benchmarex/BGA_Station_Atmel_1.1/README.md

# BGA_Station_Atmel_1.1
Program and schematic controller

PL

Program napisany przeze mnie w Atmel studio 6 w języku C na procesoprze XMEGA128-L

Stcja lutownicza do wymiany i lutowania układów BGA w płytach głównych. 

Projekt składa się z podgrzewacza dolnego o mocy 1600W (4 promienniki podczerwieni każdy po 400W) który podgrzewa naprawianą płytę. Zapewnia początkowe grzanie płyty, i poźniej grzanie po profilu lutowniczym. W odpowiednim momencie lutowania jest dołączana górna grzałka. Lutowanie i przebieg temperatury odbywa się według zaprogramowanego profilu grzewczego dla grzałki podgrzewacza dolnego i górnego. Jako grzałka górna wykorzystywana jest lampa halogonewa 100W 12V platerowana złotem. Halogeny z napylonym aluminium tzw. srebrne nie nadają się do lutowania gdyż wiekszość ciepła jest emitowana na samym halogenie a nie przekazana strumieniem podczerwieni na lutowany układ jak to ma w przypadku halogena platerowanego złotem. Nie jest stosowana żadna dodatkowa optyka wystarczy halegone zaiwsić 10-15cm nad lutowanym układem. Kontrola temperatury odbywa się za pomocą termopar 'thermocouple' są to 2 termopary typu K produkcji Omega o średnicy kulki 80um (80e-6m). Jedna termopara jest przyklajana w pobliże lutowanego układu bga około 1cm po tej samej stronie co układ BGA za pomocą taśmy kaptonowej. Druga termopara jest bezpośrednio przyklejona na lutowanym układzie BGA. Program jest automatyczny tzn wystrczy uruchomić lutowanie i cały proces lutowanie przebiegnie automatycznie, poza poózeniem i zdjeciem układu :).  Podczas wykonia programu lutowania istnieje możliwość wstrzymania, cofnięcia lub przyspieszenia programu. Czasem jest to potrzebne ze względu na czynniki losowe np. odklejenie sie termopary, duży układ, mały układ. Dodatkowo jest wbudowany mechanizm zabezpieczający przed nadmierną róznicą temperatur pomiedzy płytą i lutowanym układem. Brak takiego zabezpieczenia grozi zniszczeniem układu lub płyty (wygięcia, rozwarstwienia PCB). 
Komunikaty wyświtlane są na wyswietlaczu LCD, sterowanie odbywa się przciskami. Profil lutowniczy dla dolnej i górnej grzałki został opracowany przezmnie na podstawie własnych obserwacji i doświadczeń w lutowaniu układów BGA. Można dokonać przełączenia w typu spoiwa ołowiowe lub bezołowiowe. Dla bezołowiowego temperatura jest przeliczana o wymaganą róznicę. Czasy ekspozycji nie są zmieniane. 

EN

Program written by me in Atmel studio 6 in C language on XMEGA128-L processor

Soldering station for replacing and soldering the BGA system in motherboards.

The design consists of a bottom heater with a power of 1600W (4 radiators of 400W each), which heats the repaired board. Provide pre-heating of the board, and subsequent heating after the soldering profile. At some point in the soldering process, the top heater is attached. Soldering and temperature course is done in accordance with the heating level standard for the lower and upper heater heater. As the top heater, a 100W 12V gold-plated halogen lamp is used. Halogens with sputtered aluminum, the so-called The reverse is not visible for soldering so that most of the heat is emitted on the halogen itself and not transferred to the soldered system as in the case of gold-plated halogen. There is no standard of optics, it is enough to hang 10-15 cm above the soldered system. Temperature control is carried out using thermocouples "thermocouple" are 2 type K thermocouples manufactured by Omega with a diameter of 80um (80e-6m). One thermocouple is glued near the soldered BGA chip about 1cm on the same side as the BGA chip with Kapton. The second thermocouple is directly glued on the soldered BGA chip. The program is automatic, i.e. it is enough to call soldering and the whole soldering process will run real, apart from positioning and removing the system :). While the soldering program is running, it is possible to run, undo or accelerate the program. Sometimes it is needed due to random formation, e.g. thermocouple detachment, large system, small system. In addition, it is a mechanism against excessive temperature difference between the board and the soldered system. Lack of such protection may damage the system or the board (bends, PCB delamination).
Messages are displayed on the LCD display, operation is carried out with buttons. The soldering profile for the function and function of the heater was used by me based on observations and experiences in BGA soldering. It was possible to connect a switch to the type of lead or lead-free binder. For lead free the temperature is recalculated by the required difference. Impact times are not changed.
