benchmarex/BGA_Station_Atmel_1.1/BGA_soldering_station.PDF

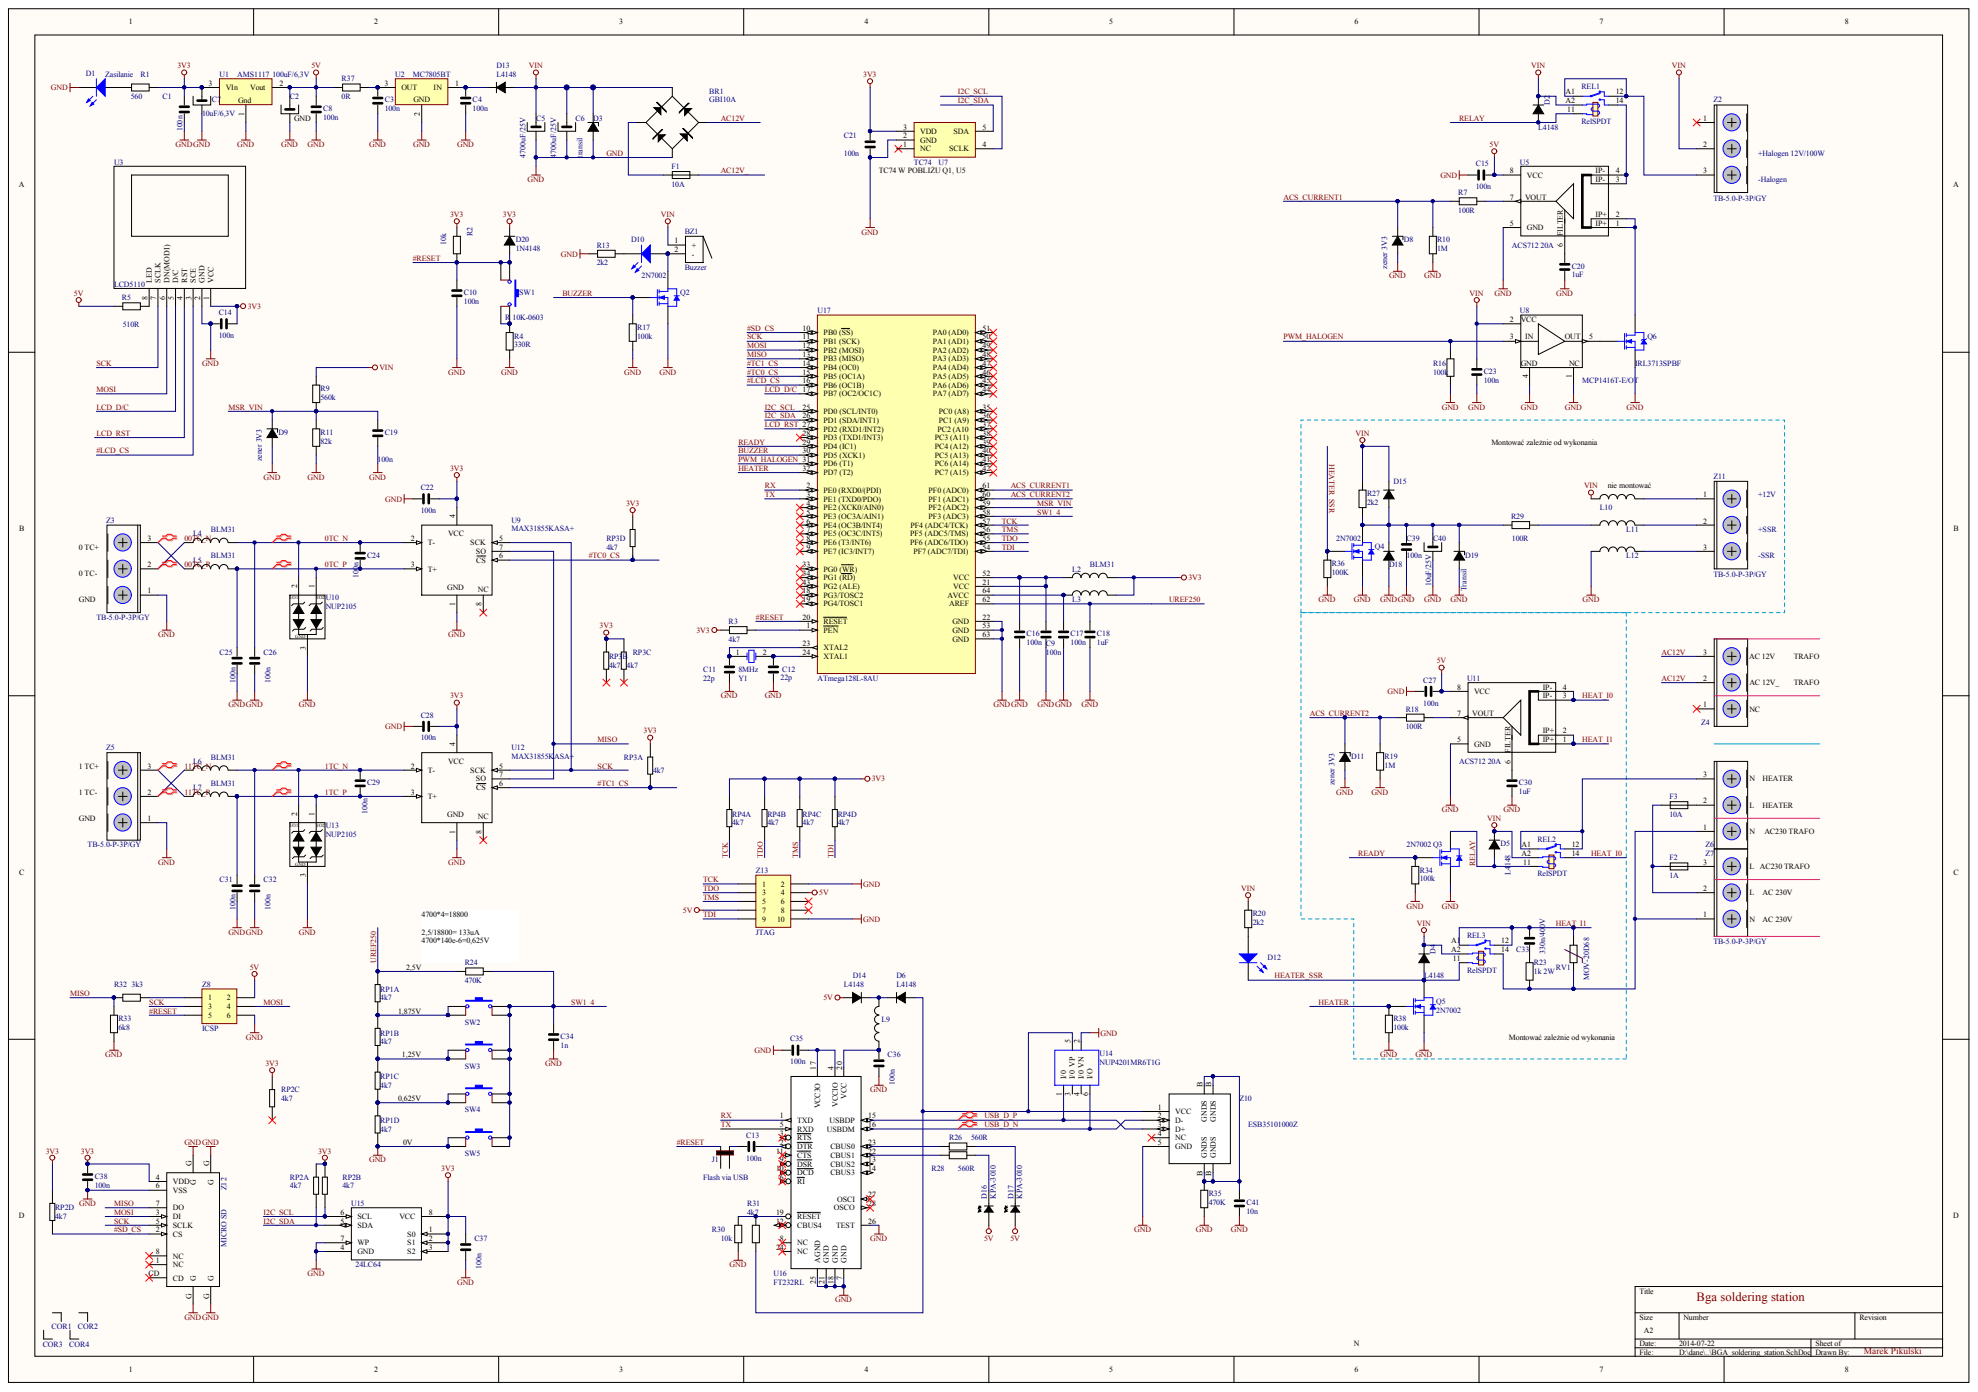
[picture p1: page 1]

VCC 1 GND 2 SCE 3 RST 4 D/C 5 DN(MODI) 6 SCLK 7 LED 8

Montować zależnie od wykonania

A1 | 12 REL2 | Z6 Z7 3

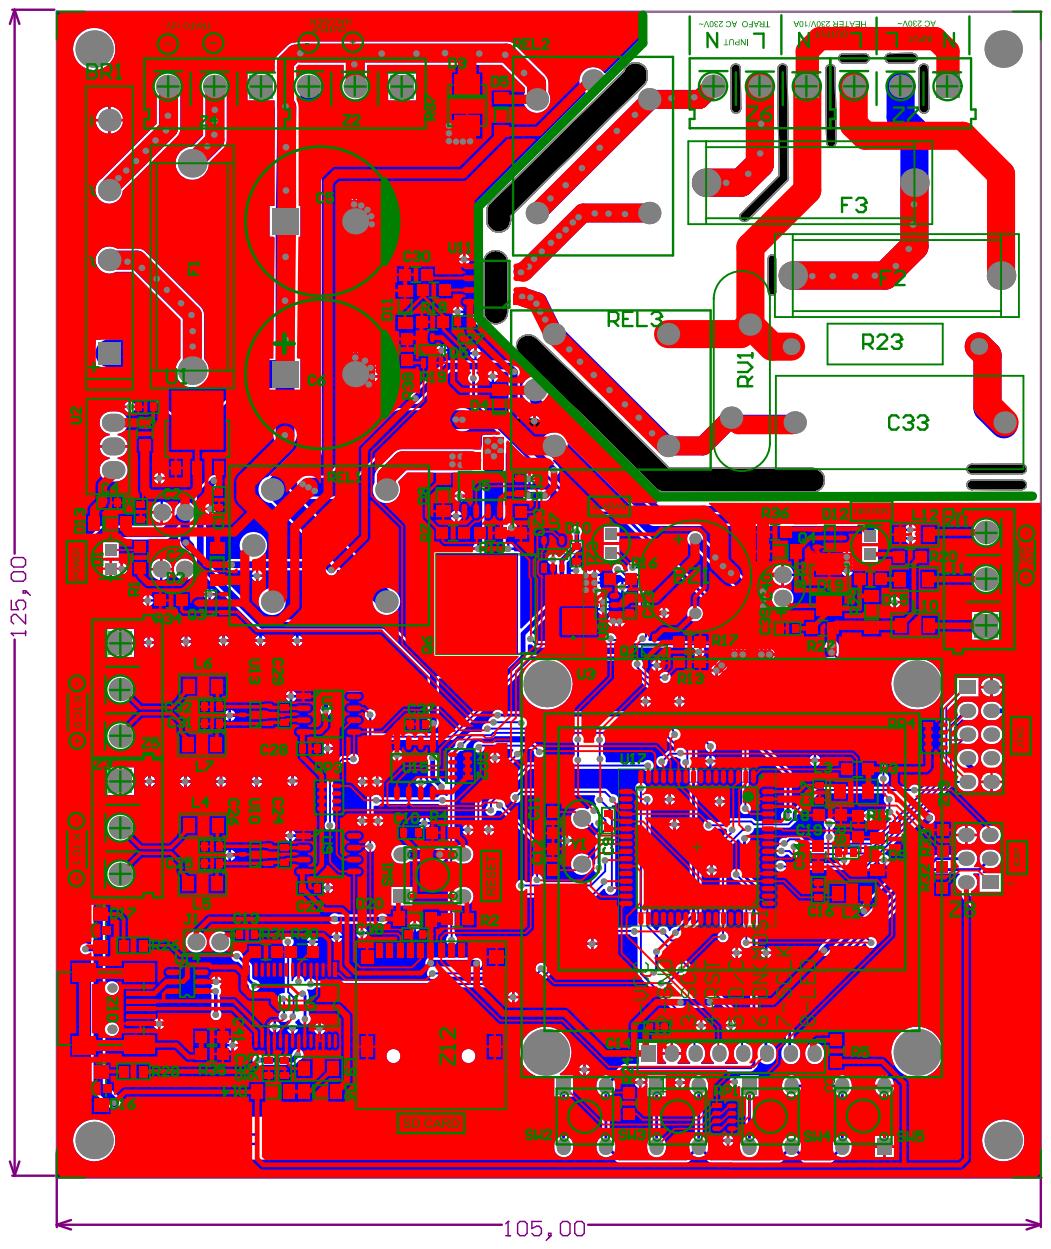
[picture p2: page 2]

Comment | Description | Designator | Footprint | LibRef | Quantity
GBI10A | DIOTEC SEMICONDUCTOR GBI10A - Mostek prostowniczy; płaski; 50V; 10A | BR1 | Mostek prostowniczy | GL1.5A | | 1
Buzzer | | BZ1 | Buzzer | Buzzer | | 1
100n | Kondensator | C1, C3, C4, C8, C9, C10, C13, C14, C15, C16, C17, C19, C21, C22, C23, C24, C25, C26, C27, C28, C29, C31, C32, C35, C36, C37, C38, C39 | 0603-C | C | 28
100uF/6,3V | | C2 | C stojący mały | Electrolitic Capacitor | | 1
4700uF/25V | | C5, C6 | C DUZY STAJACY THT | Electrolitic Capacitor | | 2
10uF/6,3V | | C7 | C stojący mały | Electrolitic Capacitor | | 1
22p | Kondensator | C11, C12 | C 805 | C | | 2
1uF | Kondensator | C18, C20, C30 | C 805 | C | | 3
330n/400V | Kondensator | C33 | C WXE-334K | C | | 1
1n | Kondensator | C34 | C 805 | C | | 1
10uF/25V | | C40 | C stojący mały | Electrolitic Capacitor | | 1
10n | Kondensator | C41 | C 805 | C | | 1
FLX_corner | Zakres obwodu drukowanego używany przez FLX2010 | COR1, COR2, COR3, COR4 | COR_1 | FLX_corner | | 4
Zasilanie | Typical BLUE SiC LED | D1 | led3 | LED3 | | 1
L4148 | Diode | D2, D4, D5, D6, D13, D14 | MINIMELF | DIODE | | 6
transil | Diode, Trransil 12V 1SMB59XXBT3 | D3, D19 | SOD90A | 1SMB59XXBT3 | | 2
zener 3V3 | | D8, D9, D11 | MINIMELF | 1SMB59XXBT3 | | 3
| Typical BLUE SiC LED | D10, D12 | led3 | LED3 | | 2
DIODE | Diode | D15, D18 | MINIMELF | DIODE | | 2
KPA-3010 | LED | D16, D17 | KPA-3010 | LED | | 2
1N4148 | Diode | D20 | MINIMELF | DIODE | | 1
10A | Bezpiecznik | F1, F3 | FUSE | FUSE | | 2
1A | Bezpiecznik | F2 | FUSE | FUSE | | 1
Flash via USB | | J1 | JP2.5 | JMP2 | | 1
BLM31 | Cewka | L2, L3, L4, L5, L6, L7, L9, L10, L11, L12 | 1206 | L | 10
2N7002 | N-channel Enhancement Mode Field-effect Transistor | Q2, Q3, Q4, Q5 | SOT23 | 2N7002 | | 4
IRL3713SPBF | HEXFET N-Channel Power MOSFET | Q6 | D2PAK | IRFBF20 | | 1
560 | Rezystor | R1 | R 805 | R | | 1
10k | Rezystor | R2, R30 | R 805 | R | | 2
4k7 | Rezystor | R3, R31 | R 805 | R | | 2
330R | Rezystor | R4 | R 805 | R | | 1
510R | Rezystor | R5 | R 805 | R | | 1
100R | Rezystor | R7, R18, R29 | R 805 | R | | 3
560k | Rezystor | R9 | R 805 | R | | 1
1M | Rezystor | R10, R19 | R 805 | R | | 2
82k | Rezystor | R11 | R 805 | R | | 1
2k2 | Rezystor | R13, R20, R27 | R 805 | R | | 3
100k | Rezystor | R16, R17, R34, R36, R38 | R 805 | R | | 5
1k 2W | Rezystor | R23 | R20/4 | R | | 1
470K | Rezystor | R24, R35 | R 805 | R | | 2
560R | Rezystor | R26, R28 | 0805 | R | | 2
3k3 | Rezystor | R32 | R 805 | R | | 1
6k8 | Rezystor | R33 | R 805 | R | | 1
0R | Rezystor | R37 | R 805 | R | | 1
RelSPDT | RELPOL RM51-3011-85-1012 - Przekaźnik: elektromagnetyczny; SPDT; Ucewki :12VDC; 10A/250VAC | REL1, REL2, REL3 | relay rm51 | RelSPDT | | 3
4k7 | drabinka 1204 4x0603 | RP1, RP2, RP3, RP4 | drabinka 4d03 | RP_MINI4 | | 4
MOV-20D68 | varistor | RV1 | MOV-20D681K | V250 | | 1
SW 6X6X4.3 | MIKROSWITCH 6X6X4.3MM THT | SW1, SW2, SW3, SW4, SW5 | MICROSWITCH 6X6X4.3 | SW 6X6X4.3 | | 5
AMS1117 | AMS1117 | U1 | sot223 | AMS1117 | | 1
MC7805BT | 3-Terminal Positive Fixed Voltage Regulator | U2 | to220.1 | MC7805BT | | 1
LCD5110 | SPI LCD NOKIA 5110 MODULE | U3 | LCD5110 | LCD5110 | | 1
ACS712 20A | ADS712 BIDIRECTIONAL CURRENT SENSOR | U5, U11 | SO8 | ACS712 | | 2
TC74 | MICROCHIP DIGITAL I2C 8BIT TEMP. | U7 | SOT23-5 | TC74 | | 1
MCP1416T-E/OT | Tiny 1.5A, High-Speed Power MOSFET Driver | U8 | SOT23-5 | MCP1416T | | 1
MAX31855KASA+ | Cold-Junction Compensated Thermocouple-to-Digital Converter | U9, U12 | SO8 | MAX31855 | | 2
NUP2105 | DUAL LINE TVS DIODE | U10, U13 | SOT23 | NUP2105 | | 2
NUP4201MR6T1G | | U14 | TSOP6 | NUP4201 | | 1
24LC64 | EEPROM | U15 | SO8 | 24LC04 | | 1
FT232RL | Single USB 2.0 to Serial UART Converter IC. | U16 | SSOP28-MAX | FT232RL | | 1
ATmega128L-8AU | 8-bit AVR Microcontroller, 4.5-5.5V, 128KB Flash, 4KB EEPROM, 4KB SRAM, 64-pin TQFP, Industrial Grade (-40°C to 85°C), Pb-Free | U17 | _64A_L | ATmega128-16AU | | 1
8MHz | Crystal Oscillator | Y1 | xtal.1 | XTAL | | 1
TB-5.0-P-3P/GY | lISTWA ZACISKOWA KĄTOWA 90ST TB-5.0-P-3P/GY NININGI | Z2, Z3, Z4, Z5, Z6, Z7, Z11 | LISTWA ZACISKOWA KĄTOWA 90ST TB-5.0-P-3P/GY NININGI | TB-5.0-P-3P | | 7
ICSP | Header, 3-Pin, Dual row | Z8 | Header 2x3 | Header 3X2 | | 1
ESB35101000Z | Gniazdo MINI USB-C kątowe SMD 5pin | Z10 | mini-usb ESB35101000Z | Mini_USB_C | | 1
MICRO SD | MICRO SD HOLDER | Z12 | MICROSD | MICRO SD | | 1
JTAG | Header, 5-Pin, Dual row | Z13 | Header 2x5 | Header 5X2 | | 1
