benchmarex/BGA_Station_Atmel_1.1/BGA_station/R_temp31855.h

/*
 * R_temp31855.h
 *
 * Created: 2015-01-21 20:25:53
 *  Author: Marek
 */ 

#ifndef R_temp31855_H_
#define R_temp31855_H_

#define FALSE                      0
#define TRUE                       1
//zwracana temperatura w st C w argumencie podaæ wyprowadzenie portu pod ktory podpiety jestr CS ukladu

int16_t  R_temp31855 ( uint8_t x );



#endif /* R_temp31855_H_ */
